guysharivker/Pre-Final-Project/README.md

# Pre-Final-Project
Greenhouse management system
WhatsApp Image 2022-06-23 at 12 57 51 PM

# Hardware Block Desgin 
Block diagram of temperature circut


temperature circut

with LM35 temp. sensor

Block diagram of humidity circut


humidity circut:

with HS1101LF humidity sensor.

Block diagram of doors circut:


doors circut:


Block diagram of light & roof circut:


light & roof circut:

with LDR sensor.

# Software Block Diagram

the code was realized with micropython and flash to Microcontroller ES32
